ZR-OIT/junior-project/README.md

# junior-project
My junior project for Oregon Institute of Technology - An electronic directory board. These files should not be copied, modified, or distributed in any way. The repository is strictly to display my previous experience.
