ZR-OIT/junior-project/CST 371 - Fall/LED schematic.jpg

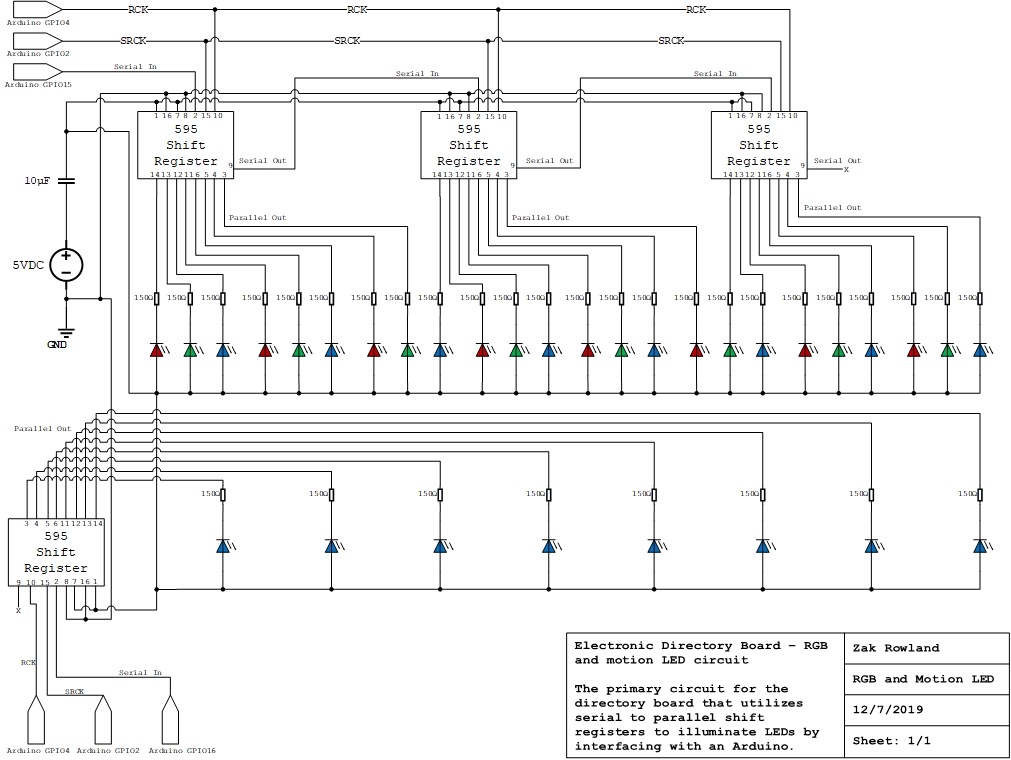
CST 371 - Fall/LED schematic.jpg
