ZR-OIT/junior-project/CST 371 - Fall/PIR schematic.jpg

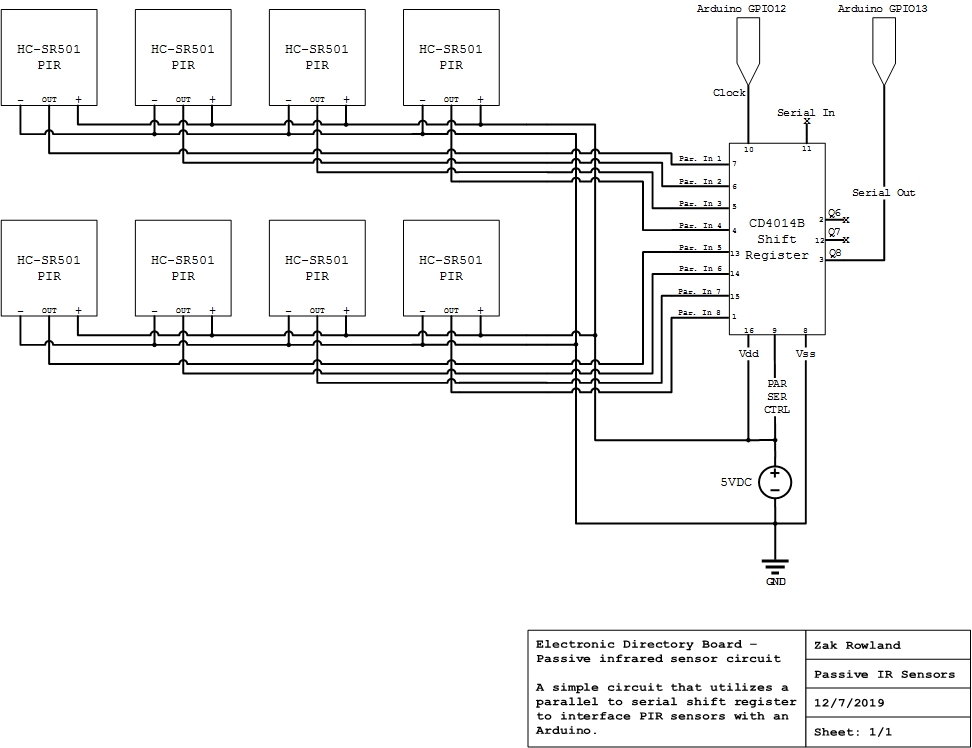
CST 371 - Fall/PIR schematic.jpg
