ZR-OIT/junior-project/CST 373 - Spring/CPLD schematic.jpg

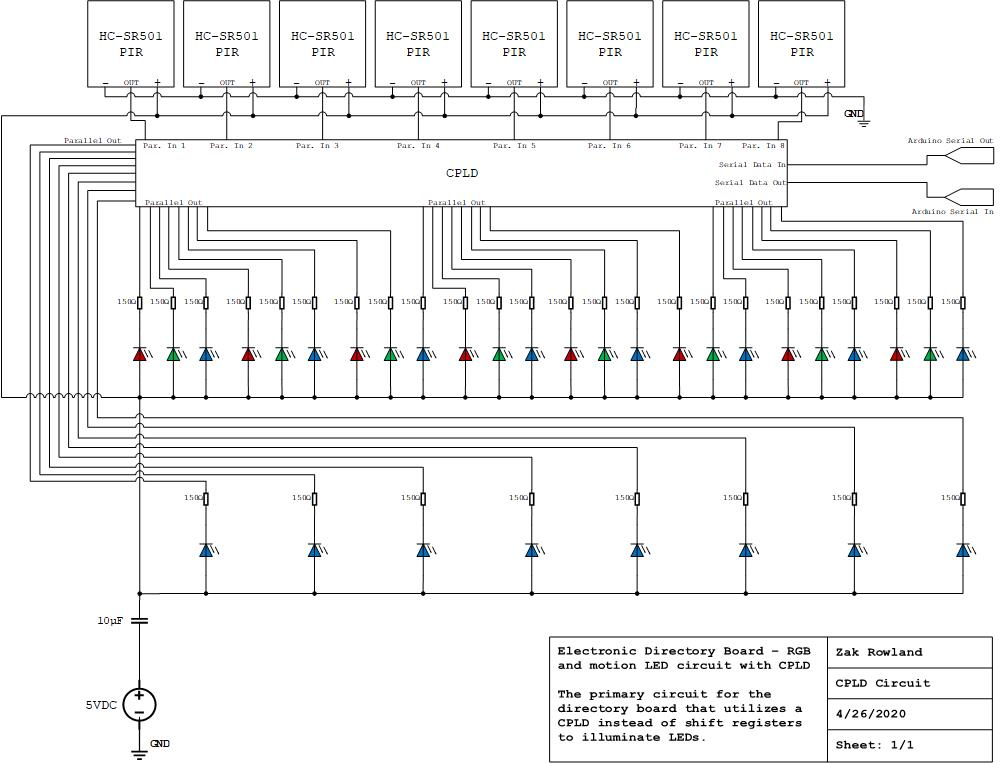
CST 373 - Spring/CPLD schematic.jpg
