ZR-OIT/junior-project/CST 371 - Fall/team comp, prelim parts, prelim cost.pdf

Composition of Your Team:
5 pts – Tell me about the team members and their individual qualifications. Identify what skills and strengths each team member brings to the table.

Zak: Design and editing experience in Photoshop or GIMP, a good understanding of C/C++ and Verilog, working on personal projects with Arduino and FPGA, 3D modeling experience in Sketchup, building circuits, and writing.

Preliminary Parts List:

Some of these parts we already have which could lower the total cost.

Module | Part | Qty. | Cost Each

Total
Cost

Alternative

Microcontroller | Arduino UNO WiFi (https://store.arduino.cc/usa/arduino-uno-wifi-rev2) | 1 | $44.90 | $44.90 | Raspberry Pi
| Arduino UNO (https://store.arduino.cc/usa/arduino-uno-rev3) | 1 | $22.00 | $0.00 | Raspberry Pi
| --- WiFi Module (https://www.sparkfun.com/products/13678) | 1 | $6.95 | $6.95 | Adafruit (https://www.adafruit.com/product/2491)
Directory Board | RGB LED (https://www.amazon.com/EDGELEC-Tri-Color-Multicolor-Resistors-Included/dp/B077X95LRZ) | 25 | $8.99 – 100 pack | $8.99 | Any other bulk pack
| Resistors (https://www.amazon.com/Cutequeen-Values-Compliant-Resistor-25pcs/dp/B016NXK6QK) | 25+ | $5.99 – 775 pack | $5.99 | Any other variety pack
| MOSFET (https://www.sparkfun.com/products/10213) | 25 | $0.90 | $22.50 | ON Semicon. (https://www.digikey.com/product-detail/en/on-semiconductor/2N7000/2N7000FS-ND/)
| Shift Register (https://www.adafruit.com/product/450) | 3 | $2.75 – 3 pack | $2.75 | Any other 74HC595
| Wire (https://www.amazon.com/BNTECHGO-Silicone-Flexible-Resistant-Insulation/dp/B01M70EDCW) | N/A | $9.48 | $9.48 | Any other generic wire (https://www.amazon.com/StrivedayTM-Flexible-Silicone-electronic-electrics/dp/B01KQ2JNLI)
| Power Supply (https://www.amazon.com/iMBAPrice-Adapter-Listed-Supply-5-Feet/dp/B00GUO5WUI) | 1 | $7.99 | $7.99 | Any other 5V/2A+
Motion Sensor | Passive Infrared Sensor (https://www.amazon.com/DIYmall-HC-SR501-Motion-Infrared-Arduino/dp/B012ZZ4LPM) | 1 | $9.49 – 5 pack | $9.49 | Any other HC-SR501
| Power Supply (https://www.amazon.com/iMBAPrice-Adapter-Listed-Supply-5-Feet/dp/B00GUO5WUI) | 1 | $7.99 | $7.99 | Any other 5V/1A+
Total: | $127.03

Preliminary Cost:

According to Payscale, entry level computer engineers make about $71,000 per year on average, entry level embedded systems engineers make about $68,000 per year on average, and entry level electrical engineers make about $75,000 per year on average. Since the team will be taking on tasks that stem from all of these fields, the average of these salaries should be considered which is about $71,000. The team will work on this project for about 9 months, so dividing the salary by 12 months gives a monthly wage of about $5,900 per month per team member. Total pay for the team for 9 months of work is about $212,000.
