ZR-OIT/junior-project/CST 371 - Fall/Motion sensor information.xlsx

Motion Sensor Information for JP Zak Rowland 10/19/2019
Types of motion sensors: | How they work: | Pros: | Cons: | Wiring example:
Passive Infrared (PIR) | Detects motion based on changes in infrared light from objects in the environment. Detected levels of IR are converted to a relative electric charge. | • Cheap • Low power • Long lifespan • Adjustable sensitivity and delay • Simple circuit | • Circuit will likely require transistors, a comparator, capacitors, and resistors | https://www.elprocus.com/wp-content/uploads/2014/09/9-10-2014-10-31-09-AM.jpg
Ultrasonic Sensor | Emits high frequency sound waves well above human hearing, these waves reflect off nearby objects and the sensor uses the time it takes for the echo to return to calculate distance/movement. | • Sensitive • Accurate | • Expensive • Prone to false alarms due to its sensitivity • Outputs pulses which must be handled in the microcontroller code to detect changes in motion | https://www.elprocus.com/wp-content/uploads/2013/08/Ultrasonic.png
Microwave Sensor | Emits microwave pulses and determine their reflection off of nearby objects to detect changes/motion. | • Sensitive • Less prone to false alarms • Higher range (can go through walls) | • Sometimes doesn't work well on non-metallic objects (humans / clothing) • Expensive to run due to power consumption | https://sc01.alicdn.com/kf/HT1VJCYFIldXXagOFbXa/201473181/HT1VJCYFIldXXagOFbXa.jpg_.webp
Tomographic Sensor | Emits radio waves and detects motion by sensing when these waves are interrupted. | • Covers a large area • Mainly used in commercial level security | • Much more expensive compared to other options • Requires a network of nodes (for one room) | https://www.digikey.com/en/articles/techzone/2013/jun/~/media/Images/Article%20Library/TechZone%20Articles/2013/June/Building%20a%20Wireless%20Motion%20Detect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
Which one should we use? | I believe we should use PIR sensors. Not only are they cheap (especially in bulk,) but they are well known and used with microcontroller and Arduino projects. This means lots of documentation, example circuits, and example code.
Potential Sensors to Purchase | Link: | Cost Per Unit: | Cost Per Sensor: | Operating Votage: | Power Consumption: | Data Sheet: | Interface:
Amazon | https://www.amazon.com/gp/product/B012ZZ4LPM | $9.49 for a pack of 5 | $1.90 | 4.5 to 20VDC | 0.29W to 1.3W | https://www.mpja.com/download/31227sc.pdf | TTL output: 3.3V high, 0V low
 | https://www.amazon.com/WGCD-HC-SR501-Pyroelectric-Infrared-Detector/dp/B01MQQAHTB/ | $14.99 for a pack of 10 | $1.50 | 4.5 to 20VDC | 0.29W to 1.3W | https://www.mpja.com/download/31227sc.pdf | TTL output: 3.3V high, 0V low
AliExpress | https://www.aliexpress.com/item/33006642306.html | $25.74 for a pack of 20 (shipping included) | $1.29 (shipping included) | 4.5 to 20VDC | 0.29W to 1.3W | https://www.mpja.com/download/31227sc.pdf | TTL output: 3.3V high, 0V low
 | https://www.aliexpress.com/item/32948972482.html | $26.27 for a pack of 20 (shipping included) (these ones include mounting brackets!) | $1.31 (shipping included) (these ones include mounting brackets!) | 4.5 to 20VDC | 0.29W to 1.3W | https://www.mpja.com/download/31227sc.pdf | TTL output: 3.3V high, 0V low
DigiKey, Mouser, Jameco all start at around $5 per sensor |  |  |  |  |  | HC-SR501
