ZR-OIT/junior-project/CST 372 - Winter/Purvine Hall map for print final.jpg

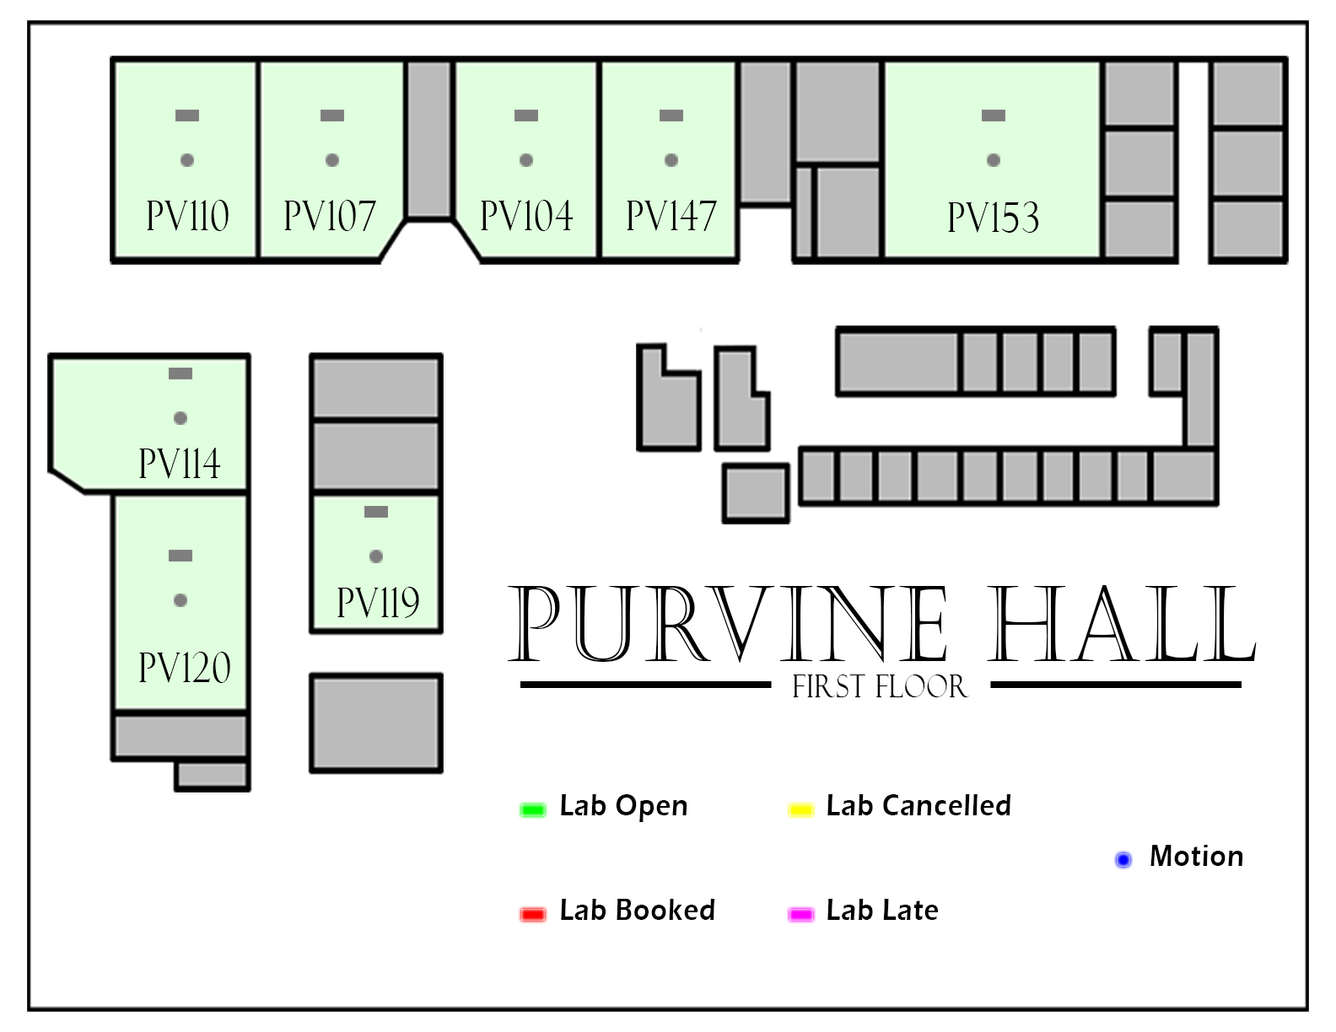
CST 372 - Winter/Purvine Hall map for print final.jpg
